HasanFairuz/smart-digital-photo-album/mechanical/CAD/Front Housing 4.0.STL

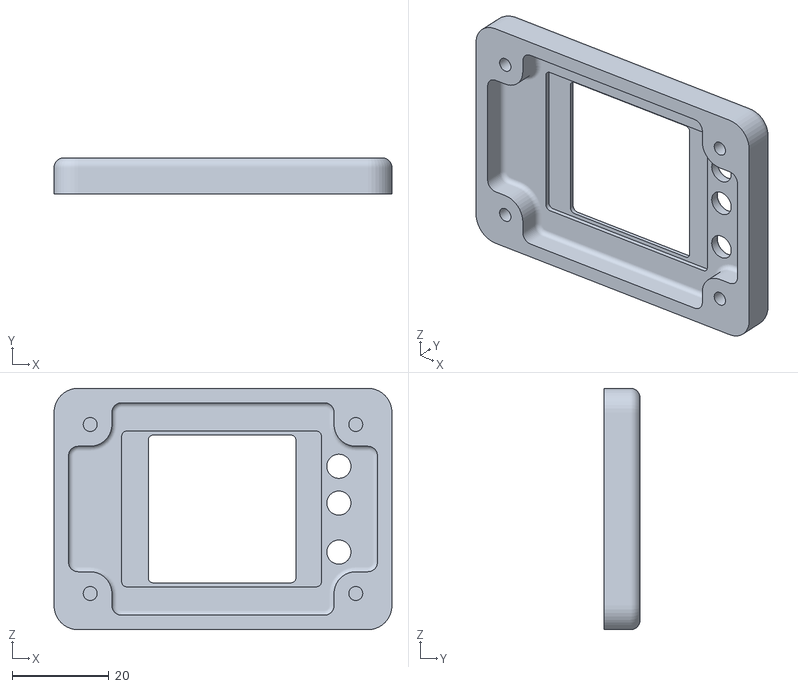
[picture p11: CAD file, 2026-10-20]
mechanical/CAD/Front Housing 4.0.STL
70.0 x 7.50 x 50.0
