HasanFairuz/smart-digital-photo-album/mechanical/CAD/Rear Housing 5.0.STL

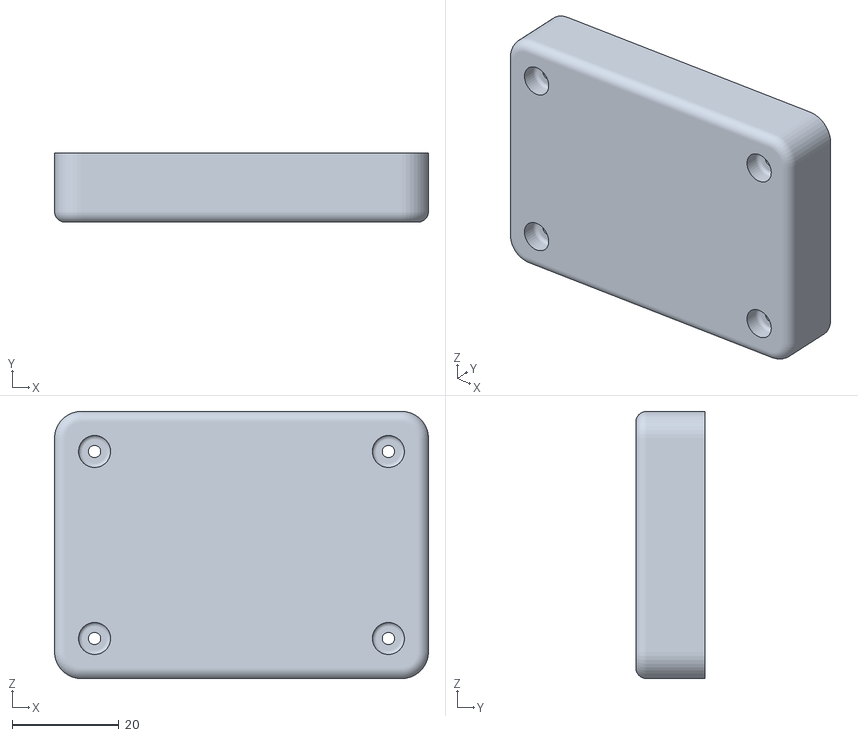
[picture p12: CAD file, 2026-10-20]
mechanical/CAD/Rear Housing 5.0.STL
70.0 x 13.0 x 50.0
