HasanFairuz/smart-digital-photo-album/mechanical/CAD/Rear Housing 6.0.STL

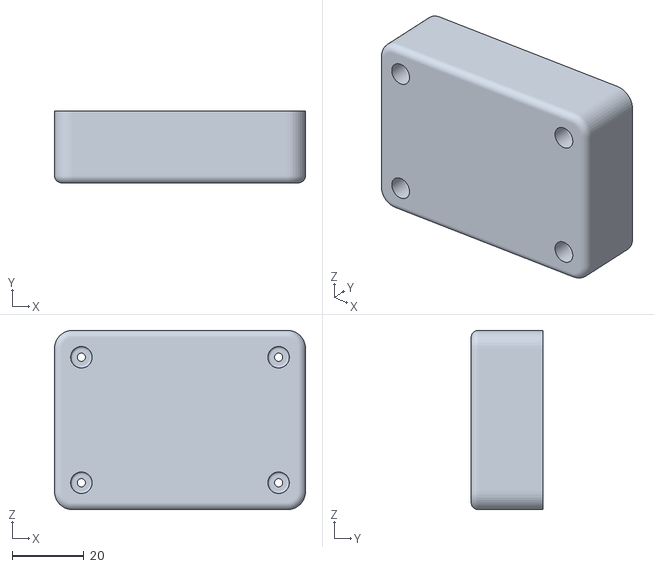
[picture p13: CAD file, 2026-10-20]
mechanical/CAD/Rear Housing 6.0.STL
70.0 x 20.0 x 50.0
