HasanFairuz/smart-digital-photo-album/(commit log)

2026-10-19 Add ESP32-S3 firmware and initial engineering documentation
    Add ESP32-S3 photo album firmware, externalize local configuration, exclude private assets, and document hardware, dependencies, setup, architecture, and testing.
2026-10-20 Add verified hardware diagrams and bill of materials
2026-10-20 CAD and Media upload
    [Front Housing 4.0.STL, Rear Housing 5.0.STL, Rear Housing 6.0.STL]
